radmilofelix/RegulusElectronicFocuser/Schematic&PCB/KiCad/Regulus Focuser-V1.remote/Focuser-V1.Remote.kicad_pcb

## KiCad design Schematic&PCB/KiCad/Regulus Focuser-V1.remote/Focuser-V1.Remote.kicad_pcb (2026-03-08)

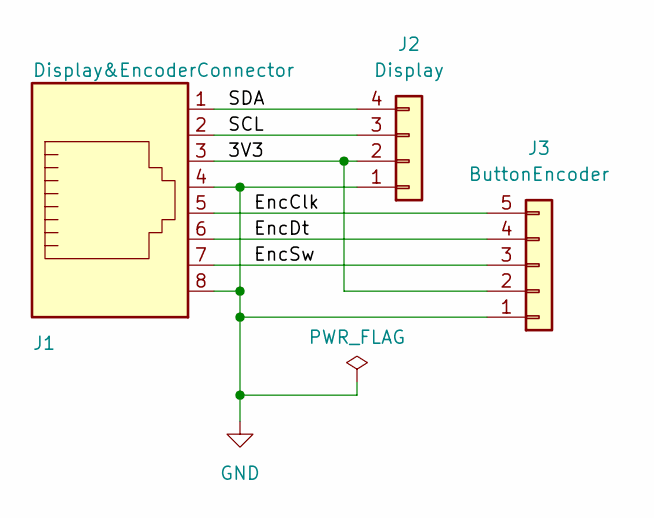
[picture p1: schematic Focuser-V1.Remote.kicad_sch, Regulus Focuser Remote Control]

Parts:
J1: Display&EncoderConnector; RJ45_Amphenol_54602-x08_Horizontal
J2: Display; PinHeader_1x04_P2.54mm_Vertical
J3: ButtonEncoder; PinHeader_1x05_P2.54mm_Vertical

Connections:
/3V3: J1.3, J2.2, J3.2
/EncClk: J1.5, J3.5
/EncDt: J1.6, J3.4
/EncSw: J1.7, J3.3
/SCL: J1.2, J2.3
/SDA: J1.1, J2.4
GND: J1.4, J1.8, J2.1, J3.1

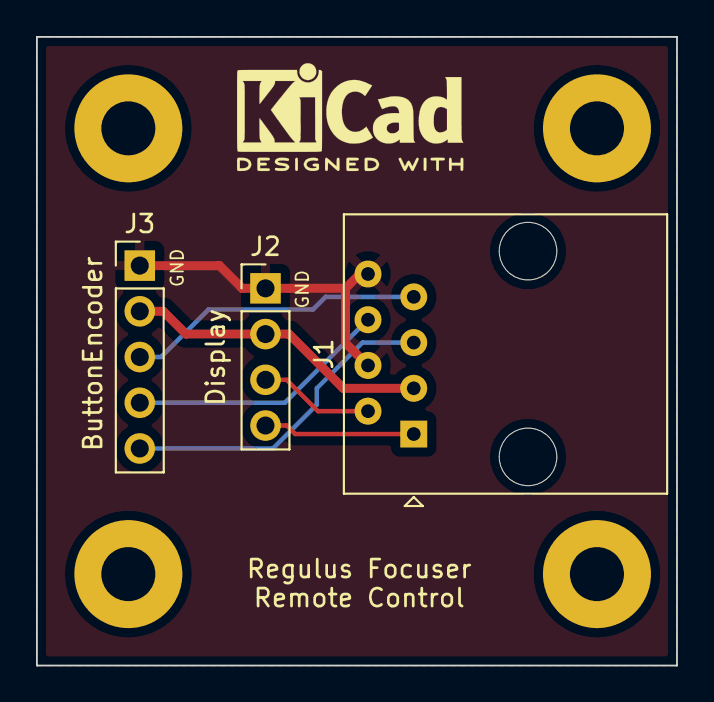
[picture p2: board Focuser-V1.Remote.kicad_pcb from above]

Board: 2 copper layers, 35.6 x 34.9 mm, 7 parts (0 on the bottom side), 7 nets.

Other parts of the board:
REF1, REF2, REF3, REF4: MountingHole_3mm_Pad
