radmilofelix/RegulusElectronicFocuser/(commit log)

2025-06-19 Code was adapted for the new INDI library v2.1.4, CMakeLists.txt optimised
    [Focuser-V1.Remote.kicad_sch, RegulusFocuser-V1.1.kicad_pcb, RegulusFocuser-V1.1.kicad_sch]
2026-03-08 Added backlash aid in firmware
    [Focuser-V1.Remote.kicad_pcb, Focuser-V1.Remote.kicad_sch, RegulusFocuser-V1.1.kicad_pcb, RegulusFocuser-V1.1.kicad_sch, RegulusFocuser-V1.kicad_sch]
2026-03-22 Fix modbus poll dimension error
    [FocuserStepper.h]
